toomuchtinkering/reflow_oven/dev_ressources/oven/specs.md

Typ: Koenic KMO 4341
Power Consumption: 1500 W
Functions: Umluft, Ober- und Unterhitze, Drehspieß
Voume: 20 litre
Inner dimensions: Width: 310 mm, Height: 170 mm, Depth: 280 mm
