toomuchtinkering/reflow_oven/dev_ressources/board_ressources/board_reference.md

# LCDwiki E32R35T board resources

Product page and data pack: https://www.lcdwiki.com/3.5inch_ESP32-32E_Display

The PDFs below are vendor-copyrighted and not redistributed in this repository.
Download them from their sources; `.gitignore` keeps local copies placed in this
directory out of commits.

## Board documents (LCDwiki)

- User manual: https://www.lcdwiki.com/res/E32R35T/3.5inch_ESP32-32E_E32R35T_E32N35T_User_Manual.pdf
- Schematic: https://www.lcdwiki.com/res/E32R35T/3.5inch_ESP32-32E_E32R35T_Schematic.pdf
- Specification V1.0: https://www.lcdwiki.com/res/E32R35T/E32R35T_E32N35T_Specification_V1.0.pdf
- ESP-IDF demo instructions: https://www.lcdwiki.com/res/E32R35T/3.5inch_E32R35T_E32N35T_ESP-IDF_Demo_Instructions.pdf
- Dimensions: https://www.lcdwiki.com/res/E32R35T/E32R35T_Size.pdf and https://www.lcdwiki.com/res/E32R35T/E32N35T_Size.pdf

## Espressif

- ESP32 datasheet: https://www.espressif.com/sites/default/files/documentation/esp32_datasheet_en.pdf
- ESP32-WROOM-32E / -32UE datasheet: https://www.espressif.com/sites/default/files/documentation/esp32-wroom-32e_esp32-wroom-32ue_datasheet_en.pdf
- ESP32 hardware design guidelines: https://docs.espressif.com/projects/esp-hardware-design-guidelines/en/latest/esp32/
- ESP32 technical reference manual: https://www.espressif.com/sites/default/files/documentation/esp32_technical_reference_manual_en.pdf

## Component datasheets

Available from each manufacturer by part number.

| Part | Role on the board |
|---|---|
| CH340C | USB-to-UART bridge |
| FM8002E | Audio power amplifier |
| ME6217 | 3.3 V LDO regulator |
| QD3579 | QDtech specification sheet (`QD3579-Specifications-A`) |
| ST7796S | LCD controller (Sitronix) |
| TP4054 | Li-ion battery charger |
| XPT2046 | Resistive touch controller |
