toomuchtinkering/reflow_oven/dev_ressources/peripherals/peripherals.md

# Peripherals

## Thermocouple amplifier

MAX31855 module with K-type thermocouple.
Shop: https://de.aliexpress.com/item/1005006635665601.html
Datasheet (Analog Devices): https://www.analog.com/en/products/max31855.html

## Solid-state relay

SSR-25DA.
Shop: https://de.aliexpress.com/item/4000899938277.html

## Speaker

Q-8R 1 W, 23 mm, 8 Ω.
Shop: https://de.aliexpress.com/item/1005006150706417.html
