toomuchtinkering/reflow_oven/dev_ressources/electrical_design/electrical_design.odp

Reflow Oven — Electrical Design

E32R35T (ESP32)

21 CS

MAX31855

K-Type

Thermocouple

Legend

19 MISO

18 SCK

T+

L (live)

N (neutral)

+3.3V

GND

T-

10 nF

PE (earth)

SSR → heater

Signal / SPI

+3.3 V

+5 V

Solid-State

GND

Heater 2

(750 W)

Ventilator

GND / 0 V

10 kΩ

Relay

Heater 1

(750 W)

+5V

32 GPIO

GND

IN

Lamp

L~

Thermal

Fuse

230 V MAINS

IEC C14 inlet

AC/DC

230 V → +5 V

Housing

Fuse 8 A

L

N

PE

PE–0V bond

PE

L

N
