toomuchtinkering/reflow_oven/docs/superpowers/plans/2026-08-30-filament-drying-mode.md

# Filament Drying Mode Implementation Plan

> **For agentic workers:** REQUIRED SUB-SKILL: Use superpowers:subagent-driven-development (recommended) or superpowers:executing-plans to implement this plan task-by-task. Steps use checkbox (`- [ ]`) syntax for tracking.

**Goal:** Add `MODE_DRYING` — a long low-temperature hold (40–100 °C for 6–12 h) that turns the reflow oven into a filament dryer.

**Architecture:** Drying is a peer run mode alongside the step test, not a new profile. The setpoint is computed analytically (`min(start + 0.05·t, target)`) so no curve array exists at any duration — the device has 37.4 KiB of free static DRAM and a 6 h curve would need ~86 KB. Two latent defects are fixed along the way: `ssr_scheduler` rounds any duty ≤ 6 % to zero (a 50 °C hold needs ~4.75 %), and `pid_step`'s anti-windup can't see an externally-applied duty cap. Runs render on the existing HOME graph rather than a new screen, because every LVGL screen permanently consumes the 64 KB pool.

**Tech Stack:** C11, ESP-IDF via PlatformIO, FreeRTOS, LVGL 9, Unity (host tests via `pio test -e native`).

**Spec:** [../specs/2026-08-30-filament-drying-mode-design.md](../specs/2026-08-30-filament-drying-mode-design.md)

---

## File structure

| File | Responsibility | Change |
|---|---|---|
| `include/config.h` | drying constants + static asserts | modify |
| `src/drivers/ssr_scheduler.h/.c` | slow-PWM quanta, now parameterised | modify |
| `src/drivers/ssr.h/.c` | active window selection | modify |
| `src/control/pid.h/.c` | output ceiling as parameter | modify |
| `src/control/reflow_sm.h/.c` | `MODE_DRYING`, drying stages, tick | modify |
| `src/control/dry_setpoint.h/.c` | **new** — analytic ramp, pure logic | create |
| `src/storage/nvs_schema.h/.c` | preset blob + validation | modify |
| `src/storage/nvs_store.h/.c` | preset load/save | modify |
| `src/oven_state.h` | drying IPC fields + `CMD_START_DRY` | modify |
| `src/control/control_task.c` | dispatch, cj gate, run_id, window | modify |
| `src/ota/telemetry_json.h/.c` | telemetry v3 drying fields | modify |
| `src/ota/ota_server.c` | populate the new view fields | modify |
| `src/ui/screen_home.c` | drying axes + rolling window | modify |
| `src/ui/screen_dry.h/.c` | **new** — DRY tab (preset list + START) | create |
| `src/ui/ui_task.c` | fourth tab, drying status wiring | modify |
| `src/web/app.js` | drying view + `kind: "dry"` archives | modify |

`dry_setpoint` is split out rather than living in `reflow_sm.c` so the ramp maths is testable in isolation and `reflow_sm.c` stays focused on state transitions.

**Run all host tests:** `pio test -e native`
**Run one suite:** `pio test -e native -f test_<name>`

---

### Task 1: Parameterise the SSR window

The bug: `threshold = (duty * 8 + 50) / 100` in integer maths means duty 1–6 % yields 0 quanta and the SSR never fires at all. Drying needs ~4.75 % for a 50 °C hold.

**Files:**
- Modify: `src/drivers/ssr_scheduler.h`, `src/drivers/ssr_scheduler.c`
- Modify: `src/drivers/ssr.h`, `src/drivers/ssr.c`
- Test: `test/test_ssr_scheduler/test_ssr_scheduler.c`

- [x] **Step 1: Write the failing tests**

Append to `test/test_ssr_scheduler/test_ssr_scheduler.c`, and add every existing
call an explicit `SSR_QUANTA_PER_WINDOW` third argument (the existing five tests
must keep asserting today's behaviour):

```c
/* The defect: at the reflow window, a 5 % duty never fires. */
void test_low_duty_is_lost_at_reflow_window(void) {
    int on = 0;
    for (uint32_t t = 0; t < SSR_PWM_WINDOW_MS; t += CONTROL_TICK_MS) {
        if (ssr_scheduler_should_be_on(t, 5, SSR_QUANTA_PER_WINDOW)) on++;
    }
    TEST_ASSERT_EQUAL_INT(0, on);
}

/* The fix: at the drying window, it fires. */
void test_low_duty_survives_at_drying_window(void) {
    int on = 0;
    const uint32_t window = (uint32_t)DRY_SSR_QUANTA * CONTROL_TICK_MS;
    for (uint32_t t = 0; t < window; t += CONTROL_TICK_MS) {
        if (ssr_scheduler_should_be_on(t, 5, DRY_SSR_QUANTA)) on++;
    }
    TEST_ASSERT_EQUAL_INT(6, on);   /* (5*120+50)/100 = 6 */
}

void test_drying_window_resolves_one_percent(void) {
    int on = 0;
    const uint32_t window = (uint32_t)DRY_SSR_QUANTA * CONTROL_TICK_MS;
    for (uint32_t t = 0; t < window; t += CONTROL_TICK_MS) {
        if (ssr_scheduler_should_be_on(t, 1, DRY_SSR_QUANTA)) on++;
    }
    TEST_ASSERT_EQUAL_INT(1, on);   /* (1*120+50)/100 = 170/100 = 1 (integer division) */
}

void test_quanta_one_is_all_or_nothing(void) {
    TEST_ASSERT_FALSE(ssr_scheduler_should_be_on(0, 49, 1));
    TEST_ASSERT_TRUE(ssr_scheduler_should_be_on(0, 51, 1));
}
```

Register them in `main()`:

```c
    RUN_TEST(test_low_duty_is_lost_at_reflow_window);
    RUN_TEST(test_low_duty_survives_at_drying_window);
    RUN_TEST(test_drying_window_resolves_one_percent);
    RUN_TEST(test_quanta_one_is_all_or_nothing);
```

- [x] **Step 2: Run to verify it fails**

Run: `pio test -e native -f test_ssr_scheduler`
Expected: compile error — `too many arguments to function 'ssr_scheduler_should_be_on'`, and `DRY_SSR_QUANTA` undeclared.

- [x] **Step 3: Add the config constant**

In `include/config.h`, immediately after the `SSR_QUANTA_PER_WINDOW` definition:

```c
/* Drying uses a much longer PWM window. At the reflow window (8 quanta) the
 * scheduler's round-to-nearest drops any duty <= 6 % to zero quanta, but a
 * 50 C hold needs ~4.75 %. 120 quanta = a 30 s window = 0.83 % resolution.
 * Slow switching also reduces zero-cross SSR wear. See drying spec 2.1. */
#define DRY_SSR_QUANTA           120
_Static_assert(DRY_SSR_QUANTA >= 1, "SSR window needs at least one quantum");
```

- [x] **Step 4: Change the scheduler**

`src/drivers/ssr_scheduler.h` — replace the declaration:

```c
/* `quanta_per_window` DEFINES the window as quanta_per_window * CONTROL_TICK_MS.
 * Reflow passes SSR_QUANTA_PER_WINDOW (8); drying passes DRY_SSR_QUANTA (120).
 * Must be >= 1. */
bool ssr_scheduler_should_be_on(uint32_t now_ms, uint8_t duty_percent,
                                uint16_t quanta_per_window);
```

`src/drivers/ssr_scheduler.c`:

```c
#include "drivers/ssr_scheduler.h"
#include "config.h"
#include <assert.h>

bool ssr_scheduler_should_be_on(uint32_t now_ms, uint8_t duty_percent,
                                uint16_t quanta_per_window) {
    assert(quanta_per_window >= 1);
    if (duty_percent >= 100) return true;
    if (duty_percent == 0)   return false;

    uint32_t slot = (now_ms / CONTROL_TICK_MS) % quanta_per_window;
    /* Round to nearest. */
    uint32_t threshold = ((uint32_t)duty_percent * quanta_per_window + 50) / 100;
    return slot < threshold;
}
```

- [x] **Step 5: Give the driver a selectable window**

`src/drivers/ssr.h` — add above `ssr_tick`:

```c
/* Select the PWM window used by subsequent ssr_tick calls. Set on mode entry
 * by control_task: SSR_QUANTA_PER_WINDOW for reflow/step test, DRY_SSR_QUANTA
 * for drying. Defaults to SSR_QUANTA_PER_WINDOW. */
void ssr_set_window_quanta(uint16_t quanta);
```

`src/drivers/ssr.c` — add the file-static and setter, and use it in `ssr_tick`:

```c
static const char *TAG = "ssr";

static uint16_t s_quanta = SSR_QUANTA_PER_WINDOW;

void ssr_set_window_quanta(uint16_t quanta) {
    if (quanta < 1) {
        /* Reject rather than coerce to the reflow window: that would silently
         * reinstate the defect this parameter exists to fix. Not an assert --
         * a programming error here does not warrant rebooting a mid-run oven. */
        ESP_LOGE(TAG, "ssr_set_window_quanta(0) ignored; keeping %u quanta", s_quanta);
        return;
    }
    s_quanta = quanta;
}

void ssr_tick(uint32_t now_ms, uint8_t duty_percent) {
    bool on = ssr_scheduler_should_be_on(now_ms, duty_percent, s_quanta);
    gpio_set_level(PIN_SSR, on ? 1 : 0);
}
```

- [x] **Step 6: Run tests**

Run: `pio test -e native -f test_ssr_scheduler`
Expected: PASS, 9 tests. The five pre-existing tests must still pass unchanged — that is the proof the reflow path is bit-identical.

- [x] **Step 7: Commit**

```bash
git add include/config.h src/drivers/ssr_scheduler.h src/drivers/ssr_scheduler.c \
        src/drivers/ssr.h src/drivers/ssr.c test/test_ssr_scheduler/test_ssr_scheduler.c
git commit -m "fix(ssr): parameterise the PWM window; low duties no longer vanish

At 8 quanta the round-to-nearest threshold drops any duty <= 6 % to zero, so
the SSR never fires. A 50 C drying hold needs ~4.75 %. The window becomes a
parameter: reflow keeps 8 (bit-identical), drying uses 120 for 0.83 %."
```

---

### Task 2: Make the PID output ceiling a parameter

Drying caps duty at 50 %. If that cap is applied *outside* `pid_step`, the anti-windup — which tests `raw > PID_OUTPUT_MAX` (100) — never sees it, and the integrator winds up against an invisible ceiling.

**Files:**
- Modify: `src/control/pid.h`, `src/control/pid.c`
- Modify: `src/control/control_task.c` (call site only)
- Test: `test/test_pid/test_pid.c`

- [x] **Step 1: Write the failing tests**

Append to `test/test_pid/test_pid.c`, and add `PID_OUTPUT_MAX` as the sixth
argument to every existing `pid_step` call:

```c
/* The ceiling must participate in anti-windup: the integrator has to stop
 * climbing when the OUTPUT saturates, and WHERE it stops must depend on
 * out_max. Gains are chosen so the integrator climbs over several ticks
 * (6.25/step) rather than saturating on the first call — with a large kp the
 * p_term alone exceeds the ceiling immediately, the integrator never leaves
 * 0, and the test passes vacuously even if out_max were ignored. */
static float run_to_saturation(float out_max) {
    pid_gains_t g = { .kp = 0.1f, .ki = 1.0f, .kd = 0.0f,
                      .k_hold = 0.0f, .k_rate = 0.0f };
    pid_state_t s;
    pid_init(&s, &g);
    pid_reset(&s, 25.0f);
    for (int i = 0; i < 20; i++) {
        float out = pid_step(&s, 50.0f, 0.0f, 25.0f, 0.25f, out_max);
        TEST_ASSERT_TRUE(out <= out_max + 1e-4f);
    }
    return s.integrator;
}

void test_integrator_freezes_at_custom_ceiling(void) {
    float i50 = run_to_saturation(50.0f);
    TEST_ASSERT_TRUE(i50 > 6.0f);                        /* actually integrated */
    TEST_ASSERT_FLOAT_WITHIN(0.01f, 43.75f, i50);        /* froze, didn't run away */
}

void test_freeze_point_tracks_the_ceiling(void) {
    /* The load-bearing proof: the same input sequence must freeze the
     * integrator LATER at a higher ceiling. Fails if out_max never reaches
     * the saturation test — both would freeze at the PID_OUTPUT_MAX point. */
    float i50  = run_to_saturation(50.0f);
    float i100 = run_to_saturation(100.0f);
    TEST_ASSERT_TRUE(i100 > i50);
    TEST_ASSERT_FLOAT_WITHIN(0.01f, 93.75f, i100);
}

/* Passing PID_OUTPUT_MAX must reproduce the previous behaviour exactly. */
void test_default_ceiling_matches_legacy(void) {
    pid_gains_t g = { .kp = 2.0f, .ki = 0.1f, .kd = 0.0f,
                      .k_hold = 0.0f, .k_rate = 0.0f };
    pid_state_t s;
    pid_init(&s, &g);
    pid_reset(&s, 25.0f);
    float out = 0.0f;
    for (int i = 0; i < 50; i++) {
        out = pid_step(&s, 100.0f, 0.0f, 25.0f, 0.25f, PID_OUTPUT_MAX);
    }
    TEST_ASSERT_TRUE(out <= PID_OUTPUT_MAX + 1e-4f);
    TEST_ASSERT_TRUE(out > 0.0f);
}
```

Register in `main()`:

```c
    RUN_TEST(test_integrator_freezes_at_custom_ceiling);
    RUN_TEST(test_freeze_point_tracks_the_ceiling);
    RUN_TEST(test_default_ceiling_matches_legacy);
```

- [x] **Step 2: Run to verify it fails**

Run: `pio test -e native -f test_pid`
Expected: compile error — `too many arguments to function 'pid_step'`.

- [x] **Step 3: Change the signature**

`src/control/pid.h` — replace the `pid_step` declaration:

```c
/* rate: commanded setpoint slope (°C/s), from profile_curve_rate() or the
 * drying ramp rate; negative values (cool-down) are treated as 0. dt must be
 * > 0 (asserted). out_max is the duty ceiling in percent — reflow passes
 * PID_OUTPUT_MAX, drying passes DRY_DUTY_MAX_PERCENT. It participates in the
 * anti-windup saturation test, so a cap applied by the caller instead would
 * wind the integrator up invisibly. */
float pid_step(pid_state_t *s, float setpoint, float rate, float temp,
               float dt, float out_max);
```

- [x] **Step 4: Change the implementation**

`src/control/pid.c` — in `pid_step`, replace the saturation block. Only
`PID_OUTPUT_MAX` becomes `out_max`; nothing else changes:

```c
    float output;
    if (raw > out_max && error > 0.0f) {
        output = out_max;               /* freeze integrator */
    } else if (raw < PID_OUTPUT_MIN && error < 0.0f) {
        output = PID_OUTPUT_MIN;        /* freeze integrator */
    } else {
        s->integrator = i_tentative;
        output = clamp(raw, PID_OUTPUT_MIN, out_max);
    }
```

- [x] **Step 5: Update the existing call site**

`src/control/control_task.c` — the reflow `pid_step` call becomes:

```c
            float out = pid_step(&s_pid, setpoint,
                                 profile_curve_rate(s_curve, s_sm.elapsed_ms),
                                 temp_c, dt, PID_OUTPUT_MAX);
```

- [x] **Step 6: Run tests**

Run: `pio test -e native`
Expected: PASS across all suites. `test_pid`'s pre-existing tests passing unchanged is the proof reflow behaviour is untouched.

- [x] **Step 7: Commit**

```bash
git add src/control/pid.h src/control/pid.c src/control/control_task.c \
        test/test_pid/test_pid.c
git commit -m "fix(pid): output ceiling as a parameter so anti-windup can see it

A duty cap applied outside pid_step is invisible to the conditional-integration
branch, which tests against PID_OUTPUT_MAX. Drying caps at 50 %, so the ceiling
becomes a parameter. Reflow passes PID_OUTPUT_MAX and is bit-identical."
```

---

### Task 3: Drying constants in `config.h`

**Files:**
- Modify: `include/config.h`

- [x] **Step 1: Add the drying block**

Append after the SAFETY LIMITS section (`DRY_SSR_QUANTA` was already added in
Task 1 next to `SSR_QUANTA_PER_WINDOW`; leave it there):

```c
/* ============================================================
 * FILAMENT DRYING (spec 2026-08-30)
 * ============================================================ */
#define DRY_TEMP_MIN_C            40.0f
#define DRY_TEMP_MAX_C           100.0f
/* Fault above target + this. 10 C keeps PLA at 45 C tripping at 55 C, below
 * its ~60 C glass transition, so a welded SSR does not deform the spool. */
#define DRY_OVER_TEMP_MARGIN_C    10.0f
/* Refuse START above target + this. Must stay below the trip margin or a
 * start accepted at the gate would immediately fault. */
#define DRY_START_MARGIN_C         5.0f
/* HEAT_UP -> HOLD entry band. */
#define DRY_HOLD_BAND_C            2.0f
/* Overshoot after a ramp flattens is approximately rate * L, with L = 32.5 s
 * from the 2026-07-19 step test. 0.05 C/s gives ~1.6 C, well inside the 10 C
 * trip. Worst-case ramp 25->100 C is 25 min, negligible against a 6-12 h hold. */
#define DRY_RAMP_RATE_C_S          0.05f
#define DRY_DUTY_MAX_PERCENT      50.0f
/* Backstop for a target the oven cannot reach (failed element, open door,
 * over-large load): without it a run that never enters the band would heat
 * indefinitely, since the hold timer never starts. Longest legitimate ramp is
 * 25 min. Same role as COOL_DOWN_TIMEOUT_MS. */
#define DRY_HEATUP_TIMEOUT_MS  5400000u          /* 90 min */
#define DRY_HOLD_MIN_MS          60000u          /* 1 min  */
#define DRY_DURATION_MAX_MS   57600000u          /* 16 h   */
#define DRY_PRESET_COUNT             6

/* Electronics (MAX31855 cold junction) limit, GLOBAL to every mode. The oven
 * vents through the electronics bay; the 2026-07-21 hold staircase reached
 * 60 C after 40 min and was still climbing linearly, and no archived run ever
 * reached equilibrium. ESP32-WROOM-32E is rated to +85 C ambient. */
#define CJ_LIMIT_C                75.0f

_Static_assert(DRY_TEMP_MAX_C + DRY_OVER_TEMP_MARGIN_C <= OVER_TEMP_LIMIT_C,
               "drying trip point must stay below the absolute over-temp limit");
_Static_assert(DRY_TEMP_MIN_C < DRY_TEMP_MAX_C, "drying range inverted");
_Static_assert(DRY_START_MARGIN_C < DRY_OVER_TEMP_MARGIN_C,
               "a start accepted at the gate must not instantly over-temp");
_Static_assert(DRY_HOLD_MIN_MS < DRY_DURATION_MAX_MS, "drying duration range inverted");

/* Compiled preset defaults. Names are compile-time; only the values are
 * editable and persisted (an editable-name UI needs a text keyboard, the most
 * expensive widget LVGL offers, permanently in the 64 KB pool). */
#define DRY_PRESET_DEFAULTS { \
    { "PLA",   45,  360 }, \
    { "PETG",  65,  360 }, \
    { "TPU",   70,  480 }, \
    { "ASA",   60,  360 }, \
    { "Nylon", 90,  480 }, \
    { "PC",    90,  360 }, \
}
```

- [x] **Step 2: Verify the asserts compile**

Run: `pio test -e native`
Expected: PASS. A `_Static_assert` failure would surface as a compile error here.

- [x] **Step 3: Commit**

```bash
git add include/config.h
git commit -m "feat(config): drying constants, limits and preset defaults"
```

---

### Task 4: The analytic drying setpoint

Split into its own unit so the ramp maths is testable without touching state-machine transitions.

**Files:**
- Create: `src/control/dry_setpoint.h`, `src/control/dry_setpoint.c`
- Test: `test/test_dry_setpoint/test_dry_setpoint.c`

- [x] **Step 1: Write the failing test**

Create `test/test_dry_setpoint/test_dry_setpoint.c`:

```c
#include <unity.h>
#include "control/dry_setpoint.h"
#include "config.h"

void setUp(void) {}
void tearDown(void) {}

void test_starts_at_start_temp(void) {
    TEST_ASSERT_FLOAT_WITHIN(0.001f, 25.0f, dry_setpoint(25.0f, 80.0f, 0u));
}

void test_ramps_at_configured_rate(void) {
    /* 100 s at 0.05 C/s = +5 C */
    TEST_ASSERT_FLOAT_WITHIN(0.01f, 30.0f, dry_setpoint(25.0f, 80.0f, 100000u));
}

void test_clamps_at_target(void) {
    /* 25 -> 80 needs 1100 s; ask for 5000 s. */
    TEST_ASSERT_FLOAT_WITHIN(0.001f, 80.0f, dry_setpoint(25.0f, 80.0f, 5000000u));
}

void test_start_above_target_returns_target(void) {
    /* A warm oven must never produce a descending or above-target setpoint. */
    TEST_ASSERT_FLOAT_WITHIN(0.001f, 45.0f, dry_setpoint(48.0f, 45.0f, 0u));
    TEST_ASSERT_FLOAT_WITHIN(0.001f, 45.0f, dry_setpoint(48.0f, 45.0f, 10000u));
}

void test_rate_is_ramp_rate_then_zero(void) {
    TEST_ASSERT_FLOAT_WITHIN(1e-6f, DRY_RAMP_RATE_C_S,
                             dry_setpoint_rate(25.0f, 80.0f, 100000u));
    /* Past the ramp, the setpoint is flat, so the feedforward rate term is 0. */
    TEST_ASSERT_FLOAT_WITHIN(1e-6f, 0.0f,
                             dry_setpoint_rate(25.0f, 80.0f, 5000000u));
}

void test_rate_zero_when_starting_at_or_above_target(void) {
    TEST_ASSERT_FLOAT_WITHIN(1e-6f, 0.0f, dry_setpoint_rate(80.0f, 80.0f, 0u));
}

int main(void) {
    UNITY_BEGIN();
    RUN_TEST(test_starts_at_start_temp);
    RUN_TEST(test_ramps_at_configured_rate);
    RUN_TEST(test_clamps_at_target);
    RUN_TEST(test_start_above_target_returns_target);
    RUN_TEST(test_rate_is_ramp_rate_then_zero);
    RUN_TEST(test_rate_zero_when_starting_at_or_above_target);
    return UNITY_END();
}
```

- [x] **Step 2: Run to verify it fails**

Run: `pio test -e native -f test_dry_setpoint`
Expected: FAIL — `control/dry_setpoint.h: No such file or directory`.

- [x] **Step 3: Write the header**

Create `src/control/dry_setpoint.h`:

```c
/* Analytic drying setpoint — the whole reason drying needs no curve array.
 *
 *   setpoint(t) = min(start_temp_c + DRY_RAMP_RATE_C_S * t, target_c)
 *
 * A 12 h dry sampled at PROFILE_CURVE_STEP_MS would need ~170 KB against
 * 37.4 KiB of free static DRAM; this is two floats and a multiply. Pure
 * logic, no state. See drying spec 1.1.
 */
#pragma once

#include <stdint.h>

/* Setpoint in °C at `elapsed_ms` into the run. If start_temp_c >= target_c
 * the result is target_c for all t — the setpoint never descends. */
float dry_setpoint(float start_temp_c, float target_c, uint32_t elapsed_ms);

/* Commanded setpoint slope (°C/s) at `elapsed_ms`, for the feedforward
 * k_rate term: DRY_RAMP_RATE_C_S while ramping, 0 once at target. */
float dry_setpoint_rate(float start_temp_c, float target_c, uint32_t elapsed_ms);
```

- [x] **Step 4: Write the implementation**

Create `src/control/dry_setpoint.c`:

```c
#include "control/dry_setpoint.h"
#include "config.h"

float dry_setpoint(float start_temp_c, float target_c, uint32_t elapsed_ms) {
    if (start_temp_c >= target_c) return target_c;
    float sp = start_temp_c + DRY_RAMP_RATE_C_S * ((float)elapsed_ms / 1000.0f);
    return (sp > target_c) ? target_c : sp;
}

float dry_setpoint_rate(float start_temp_c, float target_c, uint32_t elapsed_ms) {
    /* Single source of truth for the ramp formula: the rate is just the
     * derivative of dry_setpoint() — nonzero only while it hasn't reached
     * target_c yet (this also covers start_temp_c >= target_c, where
     * dry_setpoint() returns target_c immediately). */
    float sp = dry_setpoint(start_temp_c, target_c, elapsed_ms);
    return (sp < target_c) ? DRY_RAMP_RATE_C_S : 0.0f;
}
```

- [x] **Step 5: Run tests**

Run: `pio test -e native -f test_dry_setpoint`
Expected: PASS, 6 tests.

- [x] **Step 6: Commit**

```bash
git add src/control/dry_setpoint.h src/control/dry_setpoint.c \
        test/test_dry_setpoint/test_dry_setpoint.c
git commit -m "feat(control): analytic drying setpoint

setpoint(t) = min(start + 0.05*t, target). No array at any duration, which is
what makes a 12 h hold fit alongside 37.4 KiB of free static DRAM."
```

---

### Task 5: Drying state machine

**Files:**
- Modify: `src/control/reflow_sm.h`, `src/control/reflow_sm.c`
- Test: `test/test_reflow_sm/test_reflow_sm.c`

- [x] **Step 1: Write the failing tests**

Append to `test/test_reflow_sm/test_reflow_sm.c`:

```c
/* ---- drying ---- */

static void dry_ticks(sm_state_t *s, float temp_c, int n) {
    float sp;
    for (int i = 0; i < n; i++) sm_dry_tick(s, temp_c, &sp);
}

void test_dry_start_requires_idle(void) {
    sm_state_t s; sm_init(&s);
    s.mode = MODE_RUNNING;
    TEST_ASSERT_FALSE(sm_start_dry(&s, 45.0f, 3600000u, 25.0f));
}

void test_dry_start_rejected_when_ota_reserved(void) {
    sm_state_t s; sm_init(&s);
    s.ota_reserved = true;
    TEST_ASSERT_FALSE(sm_start_dry(&s, 45.0f, 3600000u, 25.0f));
}

void test_dry_start_rejected_when_validation_pending(void) {
    sm_state_t s; sm_init(&s);
    s.validation = SM_VALIDATION_PENDING;
    TEST_ASSERT_FALSE(sm_start_dry(&s, 45.0f, 3600000u, 25.0f));
}

void test_dry_start_rejected_when_too_hot(void) {
    sm_state_t s; sm_init(&s);
    /* target 45 + DRY_START_MARGIN_C 5 = 50 is the ceiling */
    TEST_ASSERT_FALSE(sm_start_dry(&s, 45.0f, 3600000u, 50.1f));
    TEST_ASSERT_TRUE(sm_start_dry(&s, 45.0f, 3600000u, 49.9f));
}

void test_dry_start_clamps_target_and_duration(void) {
    sm_state_t s; sm_init(&s);
    TEST_ASSERT_TRUE(sm_start_dry(&s, 500.0f, 0xFFFFFFFFu, 25.0f));
    TEST_ASSERT_FLOAT_WITHIN(0.01f, DRY_TEMP_MAX_C, s.dry_target_c);
    TEST_ASSERT_EQUAL_UINT32(DRY_DURATION_MAX_MS, s.dry_hold_ms);

    sm_init(&s);
    TEST_ASSERT_TRUE(sm_start_dry(&s, 1.0f, 1u, 25.0f));
    TEST_ASSERT_FLOAT_WITHIN(0.01f, DRY_TEMP_MIN_C, s.dry_target_c);
    TEST_ASSERT_EQUAL_UINT32(DRY_HOLD_MIN_MS, s.dry_hold_ms);
}

void test_dry_start_sets_initial_state(void) {
    sm_state_t s; sm_init(&s);
    TEST_ASSERT_TRUE(sm_start_dry(&s, 45.0f, 3600000u, 22.0f));
    TEST_ASSERT_EQUAL_INT(MODE_DRYING, s.mode);
    TEST_ASSERT_EQUAL_INT(DRY_STAGE_HEAT_UP, s.dry_stage);
    TEST_ASSERT_EQUAL_INT(DRY_END_NONE, s.dry_end_reason);
    TEST_ASSERT_EQUAL_UINT32(0u, s.elapsed_ms);
    TEST_ASSERT_EQUAL_UINT32(0u, s.dry_hold_elapsed_ms);
    TEST_ASSERT_FLOAT_WITHIN(0.01f, 22.0f, s.dry_start_temp_c);
}

void test_dry_hold_timer_does_not_run_during_heat_up(void) {
    sm_state_t s; sm_init(&s);
    sm_start_dry(&s, 80.0f, 3600000u, 25.0f);
    dry_ticks(&s, 30.0f, 40);          /* well below the band */
    TEST_ASSERT_EQUAL_INT(DRY_STAGE_HEAT_UP, s.dry_stage);
    TEST_ASSERT_EQUAL_UINT32(0u, s.dry_hold_elapsed_ms);
    TEST_ASSERT_EQUAL_UINT32(40u * CONTROL_TICK_MS, s.elapsed_ms);
}

void test_dry_enters_hold_at_band(void) {
    sm_state_t s; sm_init(&s);
    sm_start_dry(&s, 80.0f, 3600000u, 25.0f);
    dry_ticks(&s, 77.9f, 1);           /* band is target - 2.0 = 78.0 */
    TEST_ASSERT_EQUAL_INT(DRY_STAGE_HEAT_UP, s.dry_stage);
    dry_ticks(&s, 78.1f, 1);
    TEST_ASSERT_EQUAL_INT(DRY_STAGE_HOLD, s.dry_stage);
}

void test_dry_hold_is_one_way(void) {
    sm_state_t s; sm_init(&s);
    sm_start_dry(&s, 80.0f, 3600000u, 25.0f);
    dry_ticks(&s, 79.0f, 1);
    TEST_ASSERT_EQUAL_INT(DRY_STAGE_HOLD, s.dry_stage);
    dry_ticks(&s, 40.0f, 4);           /* transient dip must not revert */
    TEST_ASSERT_EQUAL_INT(DRY_STAGE_HOLD, s.dry_stage);
    TEST_ASSERT_EQUAL_UINT32(5u * CONTROL_TICK_MS, s.dry_hold_elapsed_ms);
}

void test_dry_completes_after_hold_duration(void) {
    sm_state_t s; sm_init(&s);
    /* Shortest hold sm_start_dry will accept; anything less is clamped up to
     * DRY_HOLD_MIN_MS (see test_dry_start_clamps_target_and_duration). */
    const uint32_t hold  = DRY_HOLD_MIN_MS;
    const int      ticks = (int)(hold / CONTROL_TICK_MS);
    sm_start_dry(&s, 80.0f, hold, 25.0f);
    TEST_ASSERT_EQUAL_UINT32(hold, s.dry_hold_ms);
    dry_ticks(&s, 79.0f, ticks - 1);
    TEST_ASSERT_EQUAL_INT(MODE_DRYING, s.mode);
    float sp;
    TEST_ASSERT_FALSE(sm_dry_tick(&s, 79.0f, &sp));   /* last tick ends it */
    TEST_ASSERT_EQUAL_INT(MODE_IDLE, s.mode);
    TEST_ASSERT_EQUAL_INT(DRY_END_COMPLETE, s.dry_end_reason);
}

void test_dry_heatup_timeout(void) {
    sm_state_t s; sm_init(&s);
    sm_start_dry(&s, 100.0f, 3600000u, 25.0f);
    /* Never reaches the band. */
    const int ticks = (int)(DRY_HEATUP_TIMEOUT_MS / CONTROL_TICK_MS);
    dry_ticks(&s, 30.0f, ticks - 1);
    TEST_ASSERT_EQUAL_INT(MODE_DRYING, s.mode);
    float sp;
    TEST_ASSERT_FALSE(sm_dry_tick(&s, 30.0f, &sp));
    TEST_ASSERT_EQUAL_INT(MODE_IDLE, s.mode);
    TEST_ASSERT_EQUAL_INT(DRY_END_HEATUP_TIMEOUT, s.dry_end_reason);
}

void test_dry_stop_event(void) {
    sm_state_t s; sm_init(&s);
    sm_start_dry(&s, 80.0f, 3600000u, 25.0f);
    dry_ticks(&s, 79.0f, 3);
    TEST_ASSERT_TRUE(sm_dry_stop(&s));
    TEST_ASSERT_EQUAL_INT(MODE_IDLE, s.mode);
    TEST_ASSERT_EQUAL_INT(DRY_END_MANUAL_STOP, s.dry_end_reason);
}

void test_dry_fault_records_reason(void) {
    sm_state_t s; sm_init(&s);
    sm_start_dry(&s, 80.0f, 3600000u, 25.0f);
    sm_trip_fault(&s, FAULT_OVER_TEMP);
    TEST_ASSERT_EQUAL_INT(MODE_FAULT, s.mode);
    TEST_ASSERT_EQUAL_INT(DRY_END_FAULT, s.dry_end_reason);
}

void test_dry_tick_reports_setpoint(void) {
    sm_state_t s; sm_init(&s);
    sm_start_dry(&s, 80.0f, 3600000u, 25.0f);
    float sp = 0.0f;
    sm_dry_tick(&s, 30.0f, &sp);
    /* One tick elapsed: 25 + 0.05 * 0.25 s */
    TEST_ASSERT_FLOAT_WITHIN(0.05f, 25.0f, sp);
}

void test_dry_tick_ignores_wrong_mode(void) {
    sm_state_t s; sm_init(&s);
    float sp = 0.0f;
    TEST_ASSERT_FALSE(sm_dry_tick(&s, 30.0f, &sp));
}

void test_dry_sm_step_stop_records_reason(void) {
    sm_state_t s; sm_init(&s);
    sm_start_dry(&s, 80.0f, 3600000u, 25.0f);
    sm_step(&s, SM_EVENT_CMD_STOP, 79.0f, NULL);
    TEST_ASSERT_EQUAL_INT(MODE_IDLE, s.mode);
    /* Not DRY_END_NONE: a STOP arriving via sm_step must be indistinguishable
     * from one via sm_dry_stop. */
    TEST_ASSERT_EQUAL_INT(DRY_END_MANUAL_STOP, s.dry_end_reason);
}

void test_dry_sm_step_does_not_advance_elapsed(void) {
    sm_state_t s; sm_init(&s);
    sm_start_dry(&s, 80.0f, 3600000u, 25.0f);
    dry_ticks(&s, 30.0f, 4);
    const uint32_t before = s.elapsed_ms;
    sm_step(&s, SM_EVENT_NONE, 30.0f, NULL);
    /* sm_dry_tick owns the drying clock; sm_step must not add to it. */
    TEST_ASSERT_EQUAL_UINT32(before, s.elapsed_ms);
    TEST_ASSERT_EQUAL_INT(MODE_DRYING, s.mode);
}
```

Register all seventeen in `main()`:

```c
    RUN_TEST(test_dry_start_requires_idle);
    RUN_TEST(test_dry_start_rejected_when_ota_reserved);
    RUN_TEST(test_dry_start_rejected_when_validation_pending);
    RUN_TEST(test_dry_start_rejected_when_too_hot);
    RUN_TEST(test_dry_start_clamps_target_and_duration);
    RUN_TEST(test_dry_start_sets_initial_state);
    RUN_TEST(test_dry_hold_timer_does_not_run_during_heat_up);
    RUN_TEST(test_dry_enters_hold_at_band);
    RUN_TEST(test_dry_hold_is_one_way);
    RUN_TEST(test_dry_completes_after_hold_duration);
    RUN_TEST(test_dry_heatup_timeout);
    RUN_TEST(test_dry_stop_event);
    RUN_TEST(test_dry_fault_records_reason);
    RUN_TEST(test_dry_tick_reports_setpoint);
    RUN_TEST(test_dry_tick_ignores_wrong_mode);
    RUN_TEST(test_dry_sm_step_stop_records_reason);
    RUN_TEST(test_dry_sm_step_does_not_advance_elapsed);
```

- [x] **Step 2: Run to verify it fails**

Run: `pio test -e native -f test_reflow_sm`
Expected: compile errors — `MODE_DRYING` undeclared, `sm_start_dry` not defined.

- [x] **Step 3: Extend the header**

`src/control/reflow_sm.h` — add `MODE_DRYING` to `oven_mode_t`:

```c
typedef enum {
    MODE_IDLE,
    MODE_RUNNING,
    MODE_FAULT,
    MODE_PENDING_VALIDATION,
    MODE_STEP_TEST,
    MODE_DRYING,
} oven_mode_t;
```

Add the drying types after `steptest_end_reason_t`:

```c
/* Filament drying sub-stage. The hold timer runs ONLY in DRY_STAGE_HOLD, so a
 * long ramp cannot consume the requested hold time. */
typedef enum {
    DRY_STAGE_NONE,
    DRY_STAGE_HEAT_UP,
    DRY_STAGE_HOLD,
} dry_stage_t;

/* Why a dry ended. DRY_END_NONE = still running or never run. */
typedef enum {
    DRY_END_NONE = 0,
    DRY_END_COMPLETE,        /* hold timer expired — normal */
    DRY_END_MANUAL_STOP,
    DRY_END_HEATUP_TIMEOUT,  /* never reached the band; see DRY_HEATUP_TIMEOUT_MS */
    DRY_END_FAULT,
} dry_end_reason_t;
```

Add to `sm_state_t`, after the step-test block:

```c
    /* Filament drying. Valid only in MODE_DRYING (or just ended). */
    float            dry_target_c;
    float            dry_start_temp_c;    /* oven temp at START; ramp origin */
    uint32_t         dry_hold_ms;         /* requested hold duration */
    uint32_t         dry_hold_elapsed_ms; /* accrues in DRY_STAGE_HOLD only */
    dry_stage_t      dry_stage;
    dry_end_reason_t dry_end_reason;
```

Add the API after `sm_step_test_tick`:

```c
/* Begin a dry. Returns true if accepted (idle, not OTA-reserved, not gated,
 * and temp_c <= target_c + DRY_START_MARGIN_C). Clamps target to
 * [DRY_TEMP_MIN_C, DRY_TEMP_MAX_C] and hold to
 * [DRY_HOLD_MIN_MS, DRY_DURATION_MAX_MS]. */
bool sm_start_dry(sm_state_t *s, float target_c, uint32_t hold_ms, float temp_c);

/* Advance a dry by one CONTROL_TICK_MS. Returns true if the SSR should be
 * driven this tick and writes the setpoint to *setpoint_out; false once the
 * run has ended (mode back to MODE_IDLE, dry_end_reason populated). The
 * CALLER must run all safety gates BEFORE this — a fault path uses
 * sm_trip_fault, which records DRY_END_FAULT itself. Pure logic; the caller
 * owns the SSR and the PID. */
bool sm_dry_tick(sm_state_t *s, float temp_c, float *setpoint_out);

/* Stop a running dry (touchscreen or browser). Returns true if a dry was
 * actually stopped. */
bool sm_dry_stop(sm_state_t *s);

/* Human-readable drying stage / end reason for the UI and telemetry.
 * Static strings, never NULL. */
const char *dry_stage_name(dry_stage_t s);
const char *dry_end_name(dry_end_reason_t r);
```

- [x] **Step 4: Implement**

`src/control/reflow_sm.c` — add the include at the top:

```c
#include "control/dry_setpoint.h"
```

Give `sm_step` a `MODE_DRYING` branch mirroring the `MODE_STEP_TEST` one,
placed immediately after it. Without this, `MODE_DRYING` falls through every
early branch to the tail, where `SM_EVENT_CMD_STOP` idles the oven without
setting `dry_end_reason`, and any other event adds a second `CONTROL_TICK_MS`
to `elapsed_ms` on top of `sm_dry_tick`'s, skewing the ramp clock:

```c
    if (s->mode == MODE_DRYING) {
        /* Route STOP through sm_dry_stop so the end reason is recorded; the
         * control task calls sm_dry_tick directly for the per-tick advance.
         * Falling through to the tail would double-count elapsed_ms. */
        if (event == SM_EVENT_CMD_STOP) sm_dry_stop(s);
        return false;
    }
```

Extend `sm_trip_fault` so a fault out of drying is recorded:

```c
void sm_trip_fault(sm_state_t *s, uint8_t flag) {
    if (s->mode == MODE_STEP_TEST) s->step_end_reason = STEP_END_FAULT;
    if (s->mode == MODE_DRYING)    s->dry_end_reason  = DRY_END_FAULT;
    s->mode = MODE_FAULT;
    s->stage = STAGE_NONE;
    s->fault_flags |= flag;
}
```

Add after `sm_step_test_tick`:

```c
static void dry_end(sm_state_t *s, dry_end_reason_t why) {
    s->mode           = MODE_IDLE;
    s->stage          = STAGE_NONE;
    s->dry_stage      = DRY_STAGE_NONE;
    s->dry_end_reason = why;
}

bool sm_start_dry(sm_state_t *s, float target_c, uint32_t hold_ms, float temp_c) {
    /* Same entry guard as every other heat-producing mode. */
    if (s->mode != MODE_IDLE) return false;
    if (s->ota_reserved) return false;
    if (s->validation != SM_VALIDATION_NONE) return false;

    if (target_c < DRY_TEMP_MIN_C) target_c = DRY_TEMP_MIN_C;
    if (target_c > DRY_TEMP_MAX_C) target_c = DRY_TEMP_MAX_C;
    if (hold_ms  < DRY_HOLD_MIN_MS)      hold_ms = DRY_HOLD_MIN_MS;
    if (hold_ms  > DRY_DURATION_MAX_MS)  hold_ms = DRY_DURATION_MAX_MS;

    /* Refuse a start hotter than the target rather than silently waiting to
     * cool. Clamped target first, so the gate tracks what will actually run. */
    if (temp_c > target_c + DRY_START_MARGIN_C) return false;

    s->mode                = MODE_DRYING;
    s->stage               = STAGE_NONE;
    s->elapsed_ms          = 0;
    s->dry_target_c        = target_c;
    s->dry_start_temp_c    = temp_c;
    s->dry_hold_ms         = hold_ms;
    s->dry_hold_elapsed_ms = 0;
    s->dry_stage           = DRY_STAGE_HEAT_UP;
    s->dry_end_reason      = DRY_END_NONE;
    return true;
}

bool sm_dry_tick(sm_state_t *s, float temp_c, float *setpoint_out) {
    if (s->mode != MODE_DRYING) return false;

    s->elapsed_ms += CONTROL_TICK_MS;

    if (s->dry_stage == DRY_STAGE_HEAT_UP) {
        /* One-way: once in the band we stay in HOLD, so a transient dip
         * cannot extend the run indefinitely. */
        if (temp_c >= s->dry_target_c - DRY_HOLD_BAND_C) {
            s->dry_stage = DRY_STAGE_HOLD;
        } else if (s->elapsed_ms >= DRY_HEATUP_TIMEOUT_MS) {
            /* Target unreachable (failed element, open door, huge load).
             * Without this the hold timer never starts and heating never
             * ends. */
            dry_end(s, DRY_END_HEATUP_TIMEOUT);
            return false;
        }
    }

    if (s->dry_stage == DRY_STAGE_HOLD) {
        s->dry_hold_elapsed_ms += CONTROL_TICK_MS;
        if (s->dry_hold_elapsed_ms >= s->dry_hold_ms) {
            dry_end(s, DRY_END_COMPLETE);
            return false;
        }
    }

    *setpoint_out = dry_setpoint(s->dry_start_temp_c, s->dry_target_c,
                                 s->elapsed_ms);
    return true;
}

bool sm_dry_stop(sm_state_t *s) {
    if (s->mode != MODE_DRYING) return false;
    dry_end(s, DRY_END_MANUAL_STOP);
    return true;
}

const char *dry_stage_name(dry_stage_t s) {
    switch (s) {
        case DRY_STAGE_HEAT_UP: return "heat_up";
        case DRY_STAGE_HOLD:    return "hold";
        default:                return "none";
    }
}
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
