toomuchtinkering/reflow_oven/dev_ressources/electrical_design/schematic_preview.png

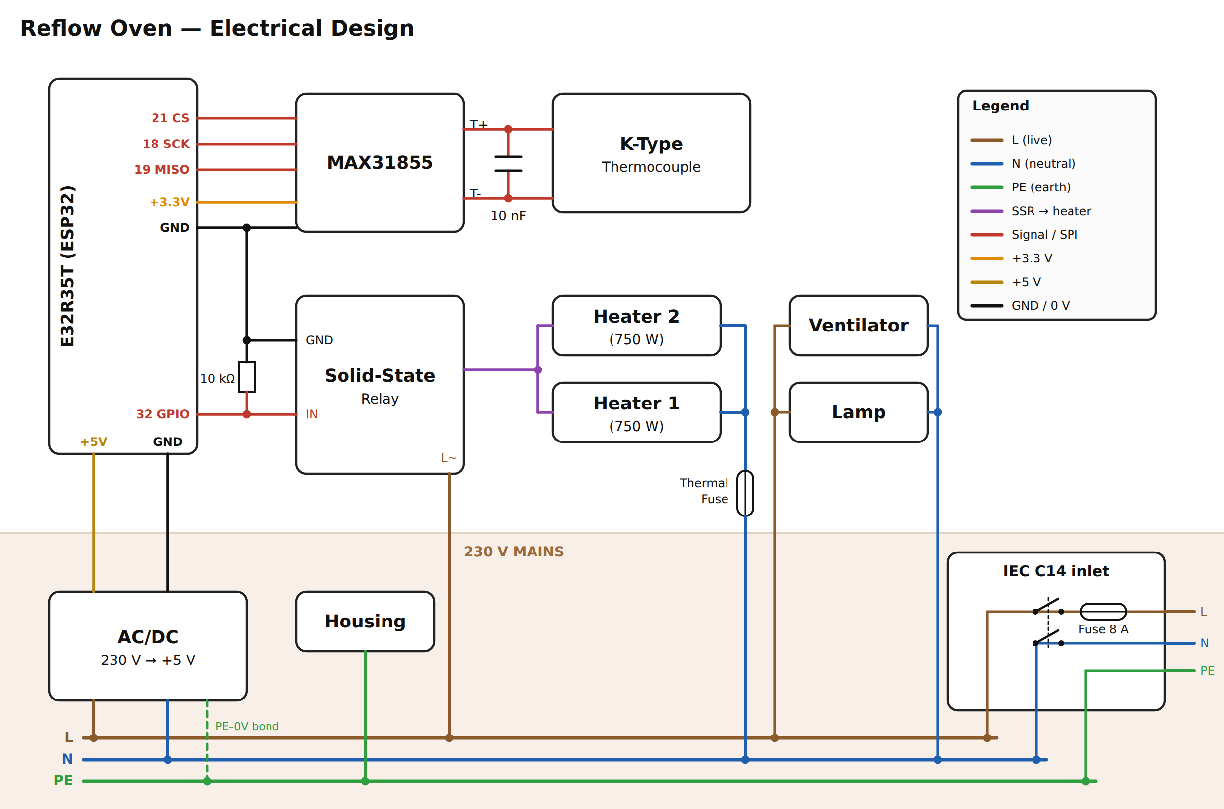
dev_ressources/electrical_design/schematic_preview.png
