toomuchtinkering/reflow_oven/dev_ressources/oven/2026_07_21_hold_fit_linear_vs_quadratic.png

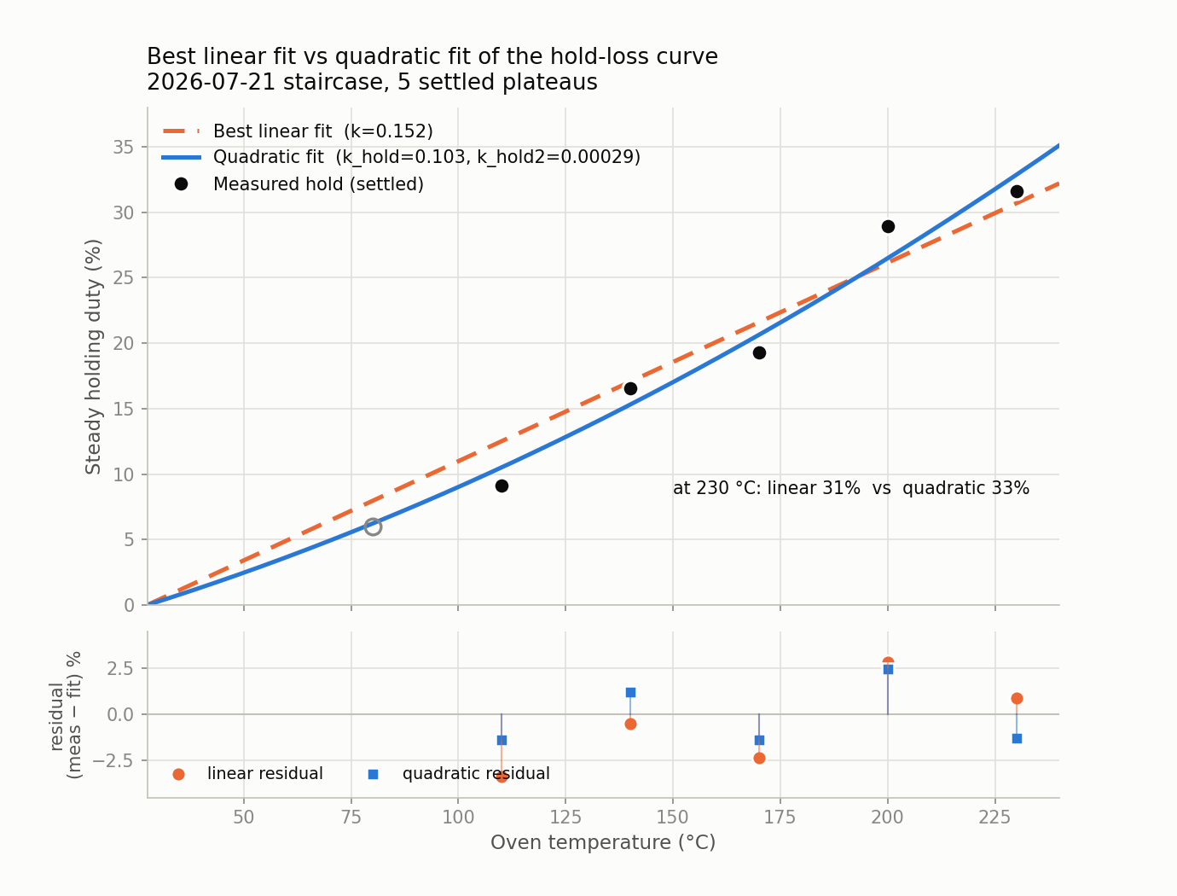
dev_ressources/oven/2026_07_21_hold_fit_linear_vs_quadratic.png
