toomuchtinkering/reflow_oven/dev_ressources/oven/2026_07_21_hold_loss_decomposition.png

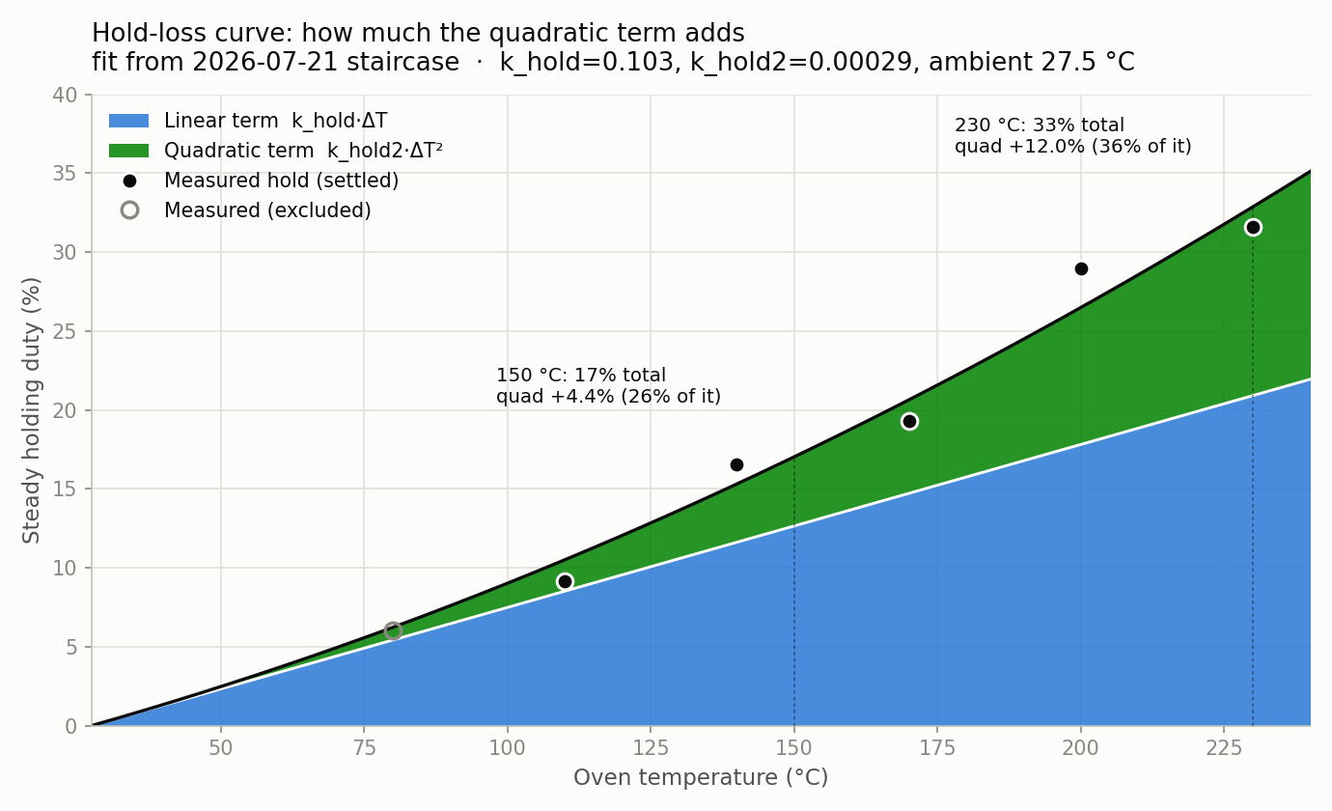
dev_ressources/oven/2026_07_21_hold_loss_decomposition.png
