toomuchtinkering/reflow_oven/dev_ressources/oven/20260419_103949.jpg

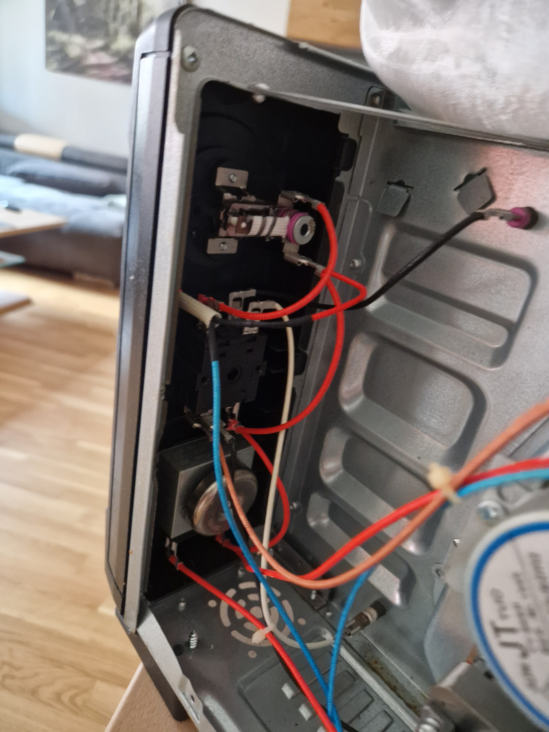
dev_ressources/oven/20260419_103949.jpg
