toomuchtinkering/reflow_oven/dev_ressources/oven/20260419_104003.jpg

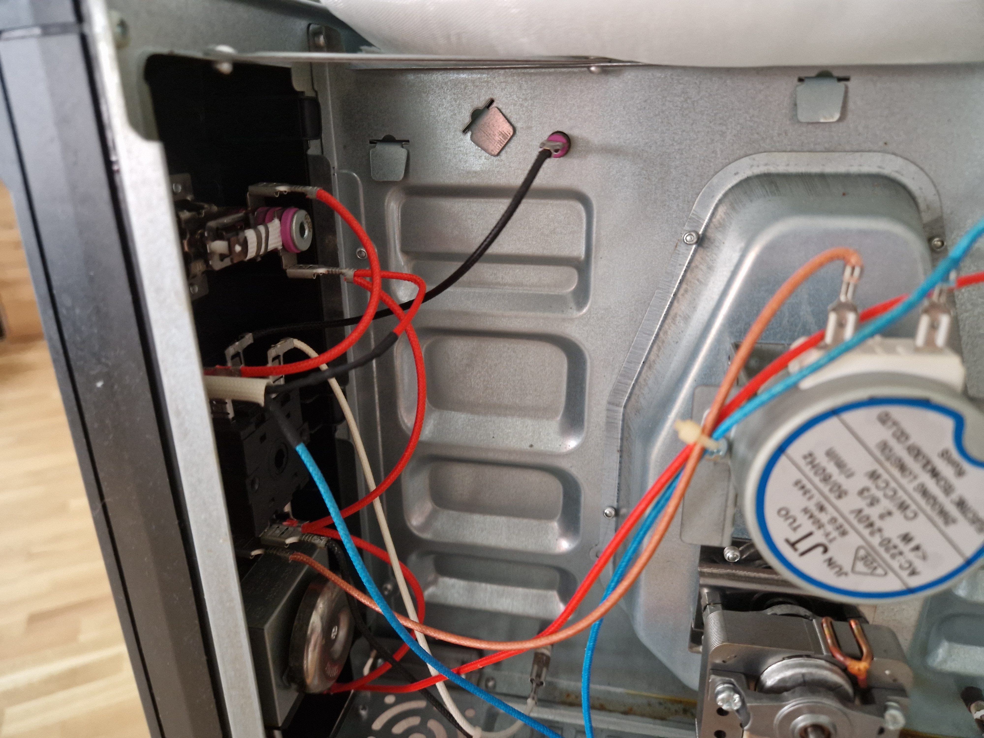
dev_ressources/oven/20260419_104003.jpg
