toomuchtinkering/reflow_oven/dev_ressources/oven/20260419_104006.jpg

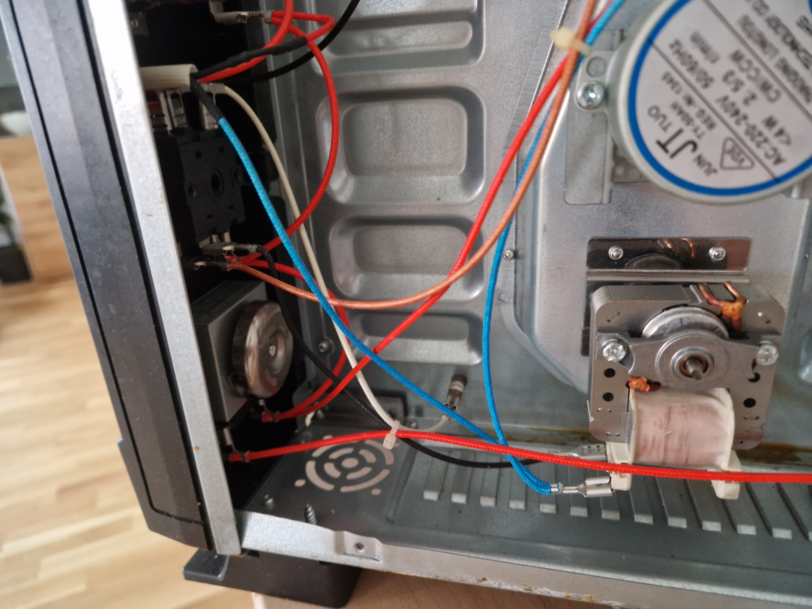
dev_ressources/oven/20260419_104006.jpg
