toomuchtinkering/reflow_oven/dev_ressources/oven/Power_Inlet_Adapter.3mf

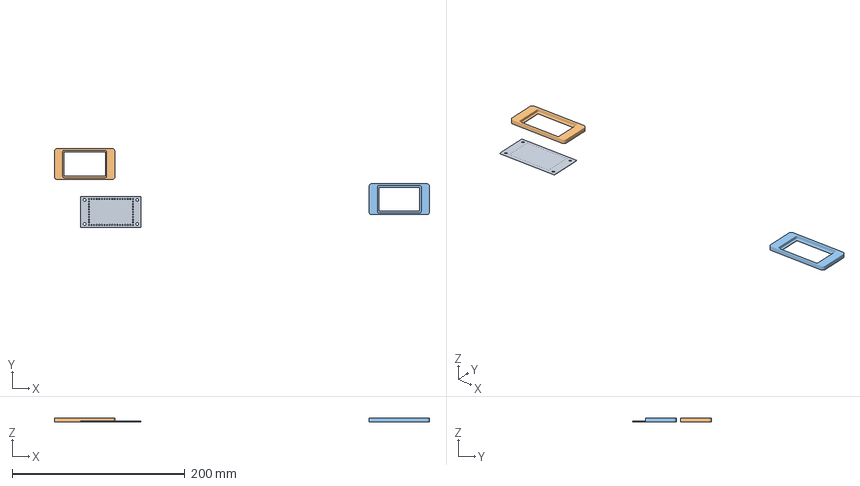
[picture p12: CAD file, 2026-10-26]
dev_ressources/oven/Power_Inlet_Adapter.3mf
434.7 x 91.5 x 4.50 mm
Sheet_Metal_Template
Adapter
Power_Inlet - Adapter_v2
