toomuchtinkering/reflow_oven/dev_ressources/oven/Intermediate_Plate_v1.1.3mf

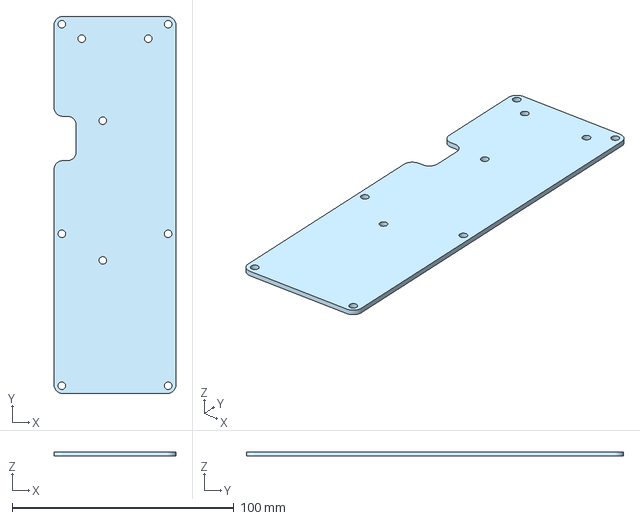
[picture p13: CAD file, 2026-10-26]
dev_ressources/oven/Intermediate_Plate_v1.1.3mf
55.0 x 170.0 x 2.00 mm
