toomuchtinkering/reflow_oven/dev_ressources/oven/Reflow_Oven_Electronics_v2.1.3mf

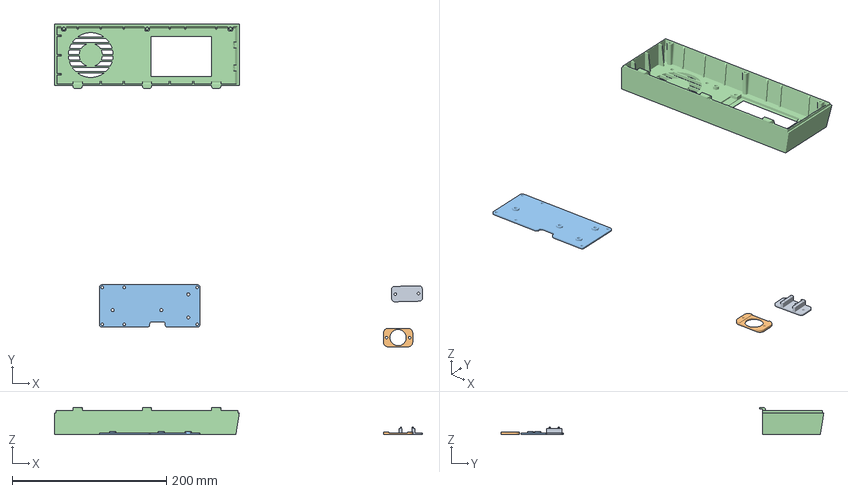
[picture p14: CAD file, 2026-10-26]
dev_ressources/oven/Reflow_Oven_Electronics_v2.1.3mf
476.8 x 418.1 x 35.0 mm
Breakout Board Mount
Speaker Holder
Intermediate_Plate
Housing
