toomuchtinkering/reflow_oven/dev_ressources/oven/Reflow_Oven_Electronics.3mf

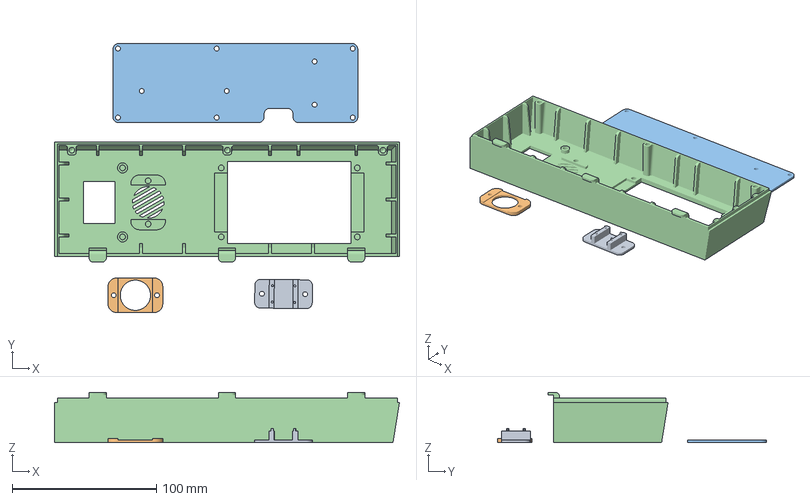
[picture p15: CAD file, 2026-10-26]
dev_ressources/oven/Reflow_Oven_Electronics.3mf
239.5 x 186.8 x 35.0 mm
Breakout Board Mount
Speaker Holder
Intermediate_Plate
Housing
