toomuchtinkering/reflow_oven/dev_ressources/oven/Reflow_Oven_Electronics_v2.3mf

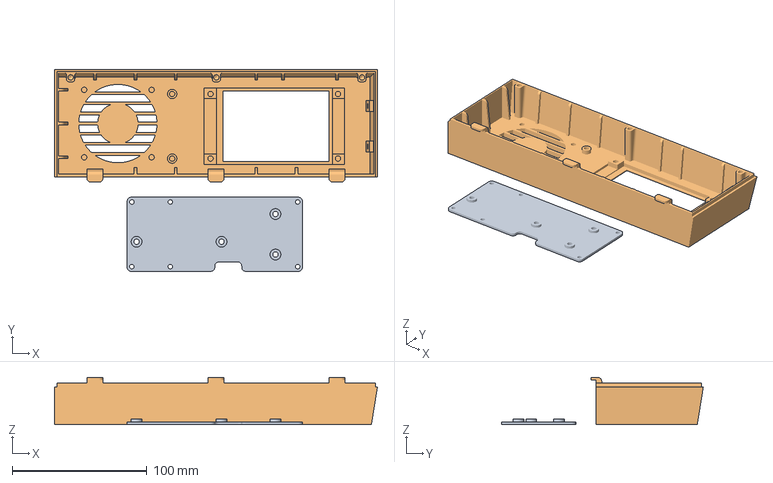
[picture p16: CAD file, 2026-10-26, an earlier design]
dev_ressources/oven/Reflow_Oven_Electronics_v2.3mf
239.5 x 149.6 x 35.0 mm
Intermediate_Plate
Housing
