toomuchtinkering/reflow_oven/dev_ressources/electrical_design/electrical_design_ORIGINAL.pdf

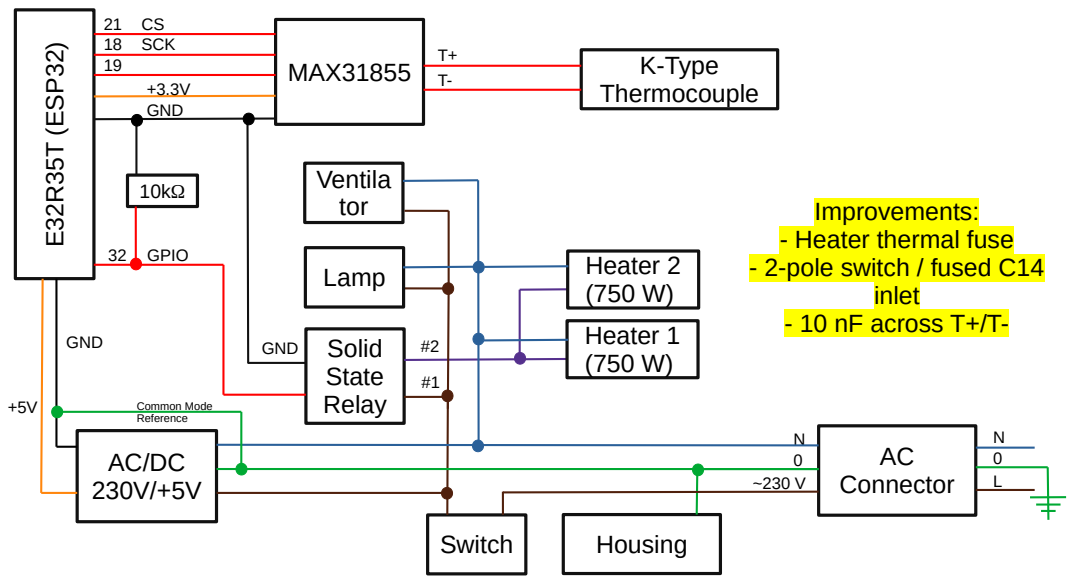
[picture p17: page 1]
Ventila tor; Solid State Relay; AC Connector; Switch; MAX31855; K-Type; Thermocouple; Housing; Heater 1 (750 W); Heater 2 (750 W); GND; Lamp; CS SCK; GPIO; +3.3V GND; Common Mode Reference; inlet - 10 nF across T+/T-

Improvements:
- Heater thermal fuse
- 2-pole switch / fused C14

~230 V
